maxeo/3dprint-skinkocchiali/documenti/anteprima.png

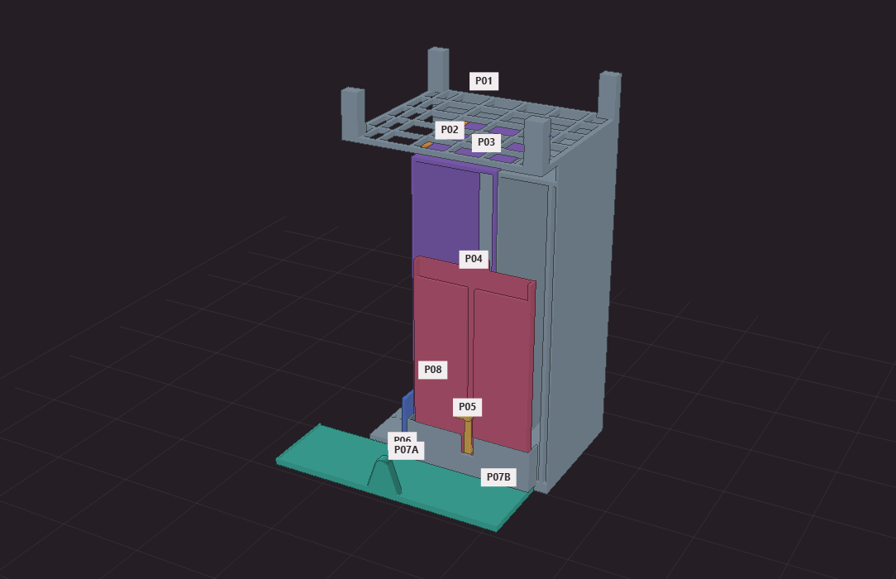
documenti/anteprima.png
