maxeo/3dprint-skinkocchiali/originale/01_modulo_principale.stl

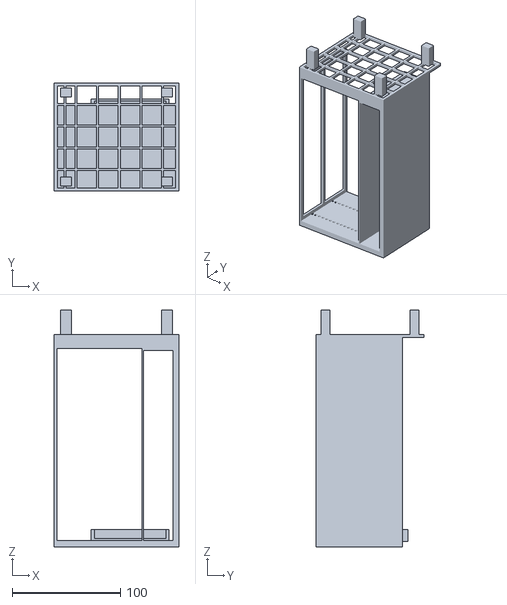
[picture p2: CAD file, 2026-09-13]
originale/01_modulo_principale.stl
115.0 x 100.0 x 218.7
