maxeo/3dprint-skinkocchiali/prove/T11_Tasca_porta_patch_con_base.stl

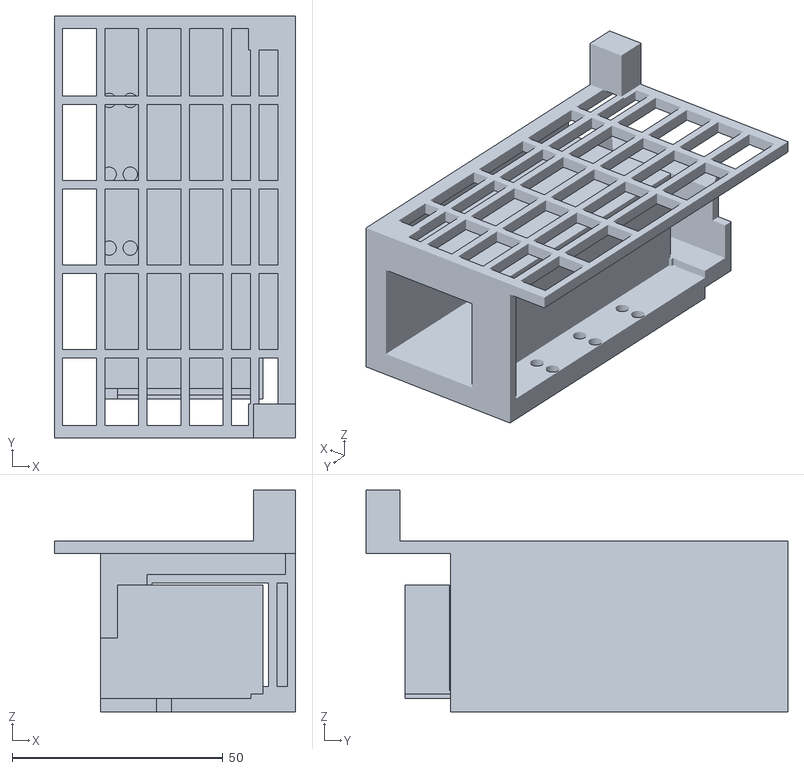
[picture p3: CAD file, 2026-10-20]
prove/T11_Tasca_porta_patch_con_base.stl
57.2 x 100.0 x 52.5
