maxeo/3dprint-skinkocchiali/stl/P01_Modulo_principale.stl

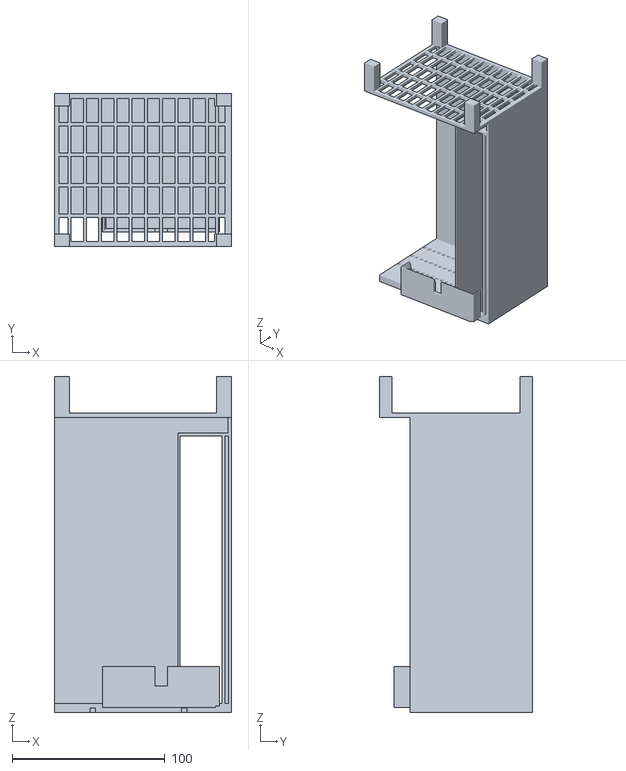
[picture p4: CAD file, 2026-10-20]
stl/P01_Modulo_principale.stl
116.2 x 100.0 x 220.3
