maxeo/3dprint-skinkocchiali/originale/04_porta_patch_traforato.stl

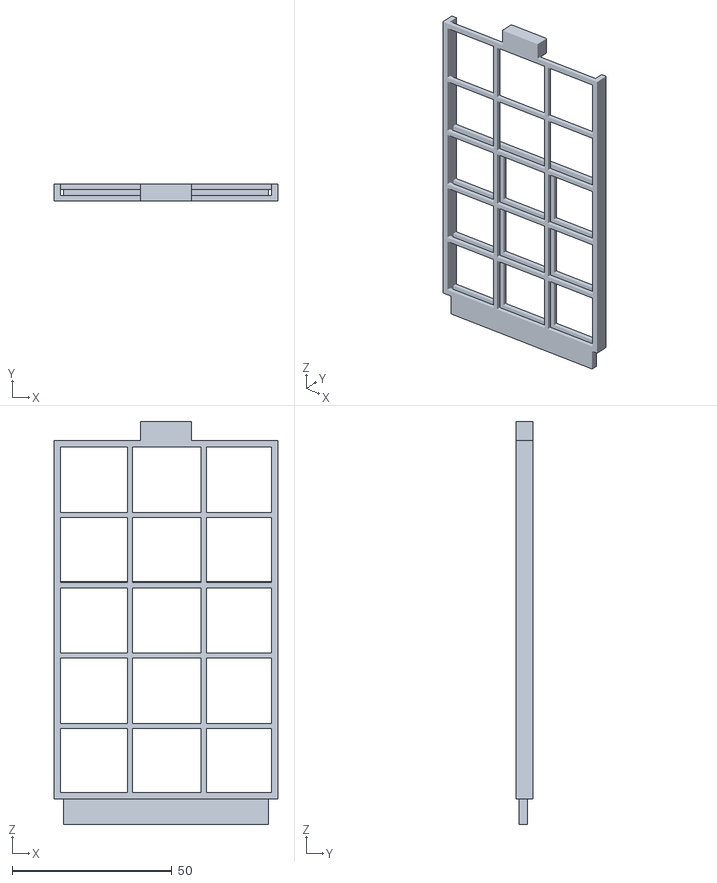
[picture p5: CAD file, 2026-09-13]
originale/04_porta_patch_traforato.stl
70.0 x 5.20 x 126.0
