maxeo/3dprint-skinkocchiali/prove/T03_Segmento_base_3_fori.stl

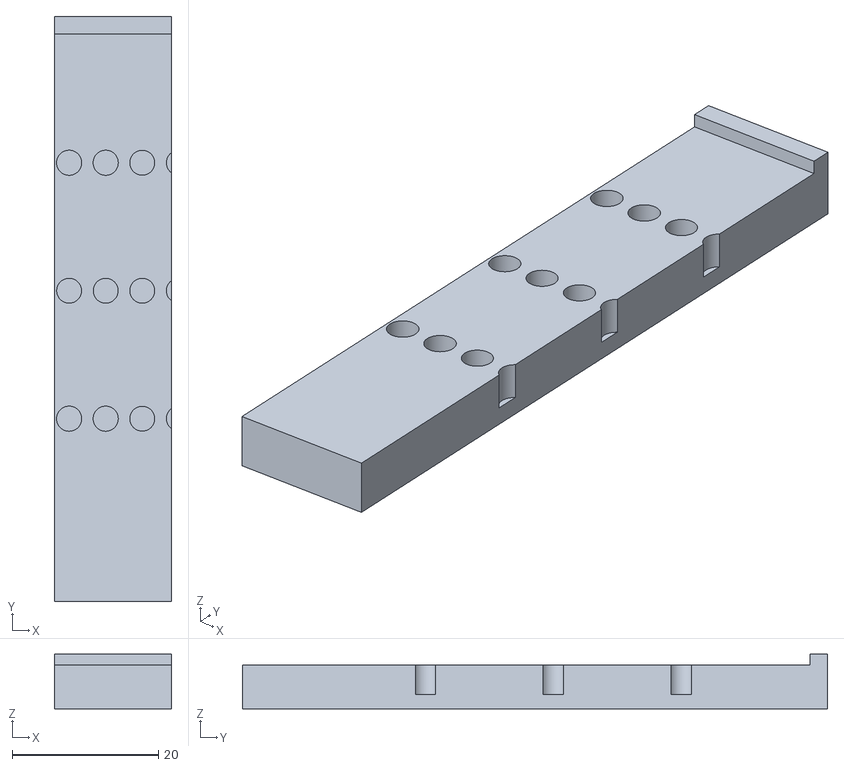
[picture p6: CAD file, 2026-10-20]
prove/T03_Segmento_base_3_fori.stl
16.0 x 80.0 x 7.50
