maxeo/3dprint-skinkocchiali/stl/P08_Fermo_L.stl

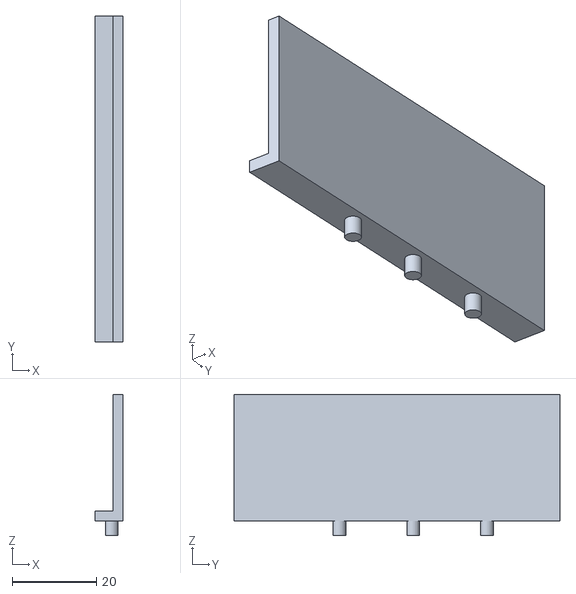
[picture p7: CAD file, 2026-09-26]
stl/P08_Fermo_L.stl
6.70 x 77.3 x 33.5
