maxeo/3dprint-skinkocchiali/originale/00_assieme_completo.stl

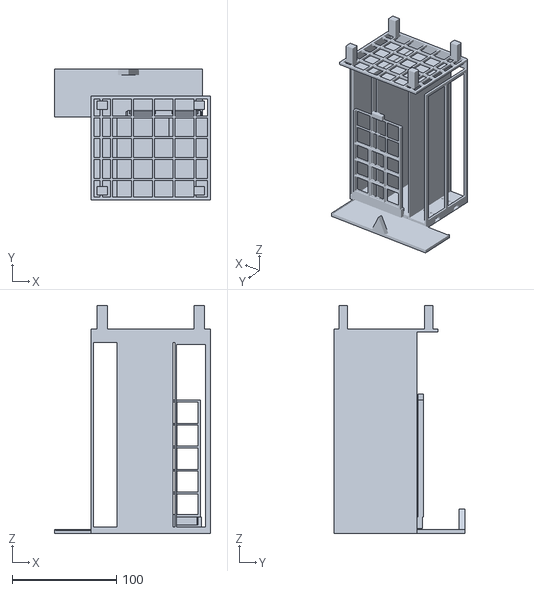
[picture p8: CAD file, 2026-09-13]
originale/00_assieme_completo.stl
150.0 x 126.1 x 218.7
