maxeo/3dprint-skinkocchiali/prove/T06_Chiave_S_spessore_1_7mm.stl

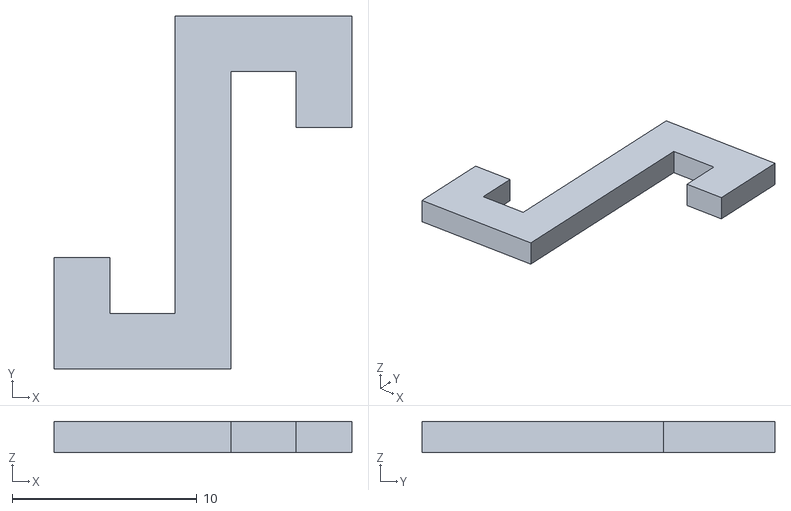
[picture p9: CAD file, 2026-10-20]
prove/T06_Chiave_S_spessore_1_7mm.stl
16.1 x 19.1 x 1.70
