maxeo/3dprint-skinkocchiali/stl/P07_Chiave_meandro.stl

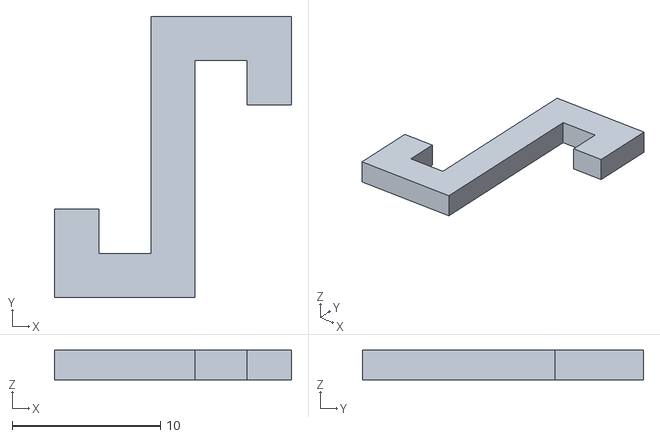
[picture p10: CAD file, 2026-09-26]
stl/P07_Chiave_meandro.stl
16.0 x 19.0 x 2.00
