maxeo/3dprint-skinkocchiali/originale/03_modulo_mobile_50x80.stl

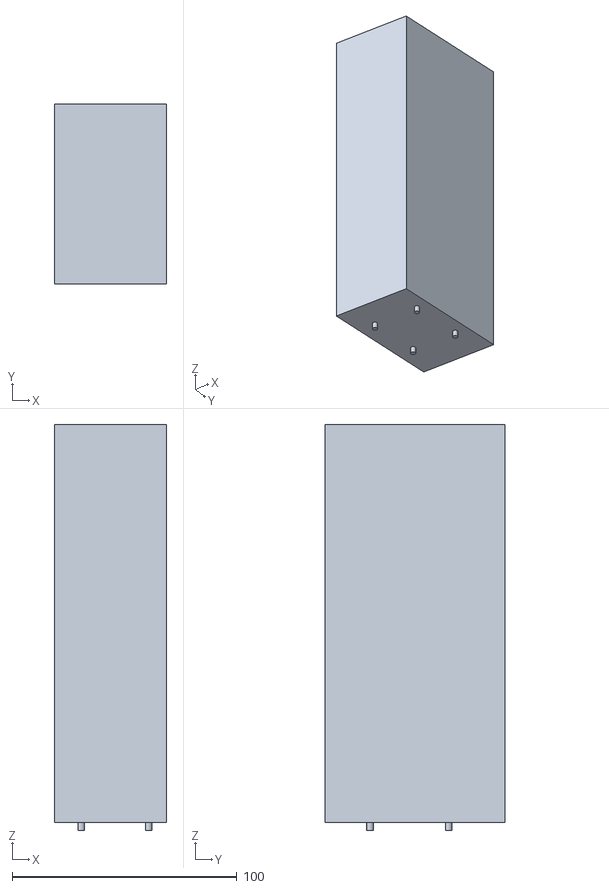
[picture p11: CAD file, 2026-09-13]
originale/03_modulo_mobile_50x80.stl
50.0 x 80.0 x 180.8
