maxeo/3dprint-skinkocchiali/prove/T08_Chiave_S_spessore_1_2mm.stl

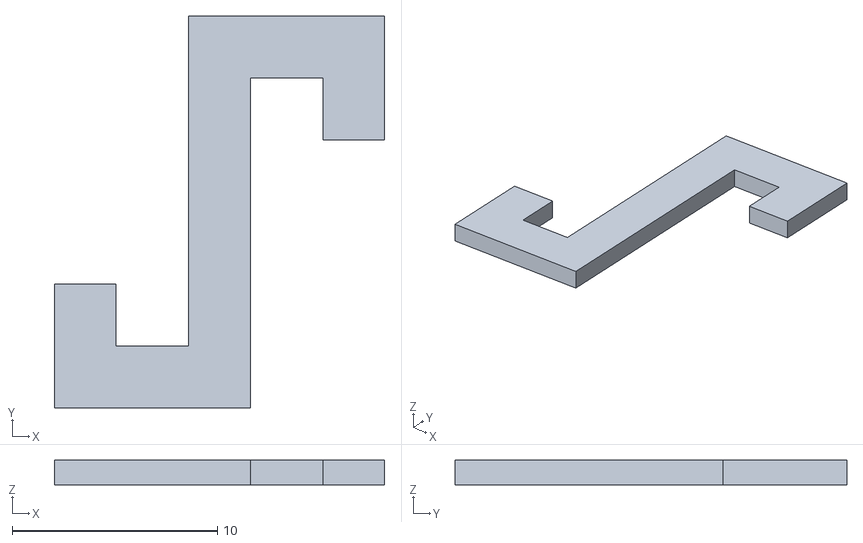
[picture p12: CAD file, 2026-10-20]
prove/T08_Chiave_S_spessore_1_2mm.stl
16.1 x 19.1 x 1.20
