maxeo/3dprint-skinkocchiali/stl/P06_Porta_occhiali.stl

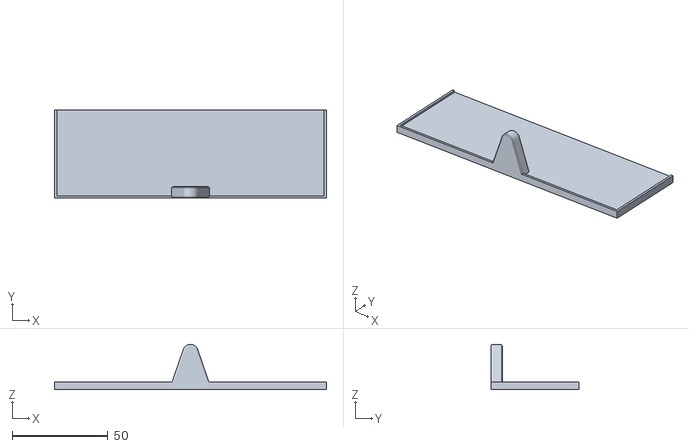
[picture p13: CAD file, 2026-09-26]
stl/P06_Porta_occhiali.stl
142.0 x 46.1 x 23.7
