maxeo/3dprint-skinkocchiali/originale/00_assieme_revisionato_NON_STAMPARE.stl

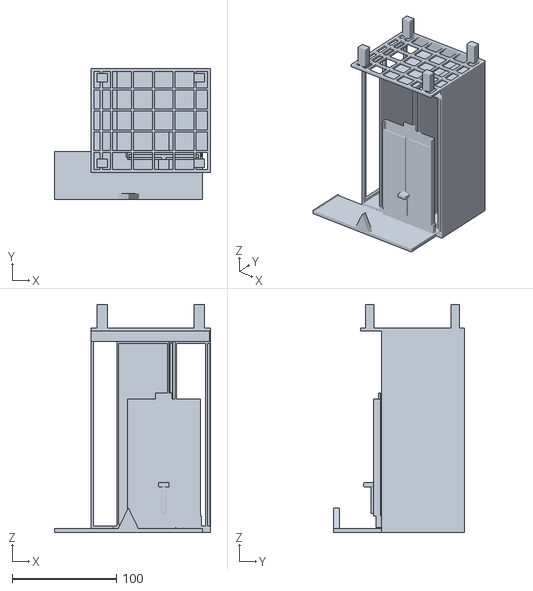
[picture p14: CAD file, 2026-09-13]
originale/00_assieme_revisionato_NON_STAMPARE.stl
150.0 x 126.1 x 218.7
