maxeo/3dprint-skinkocchiali/prove/T05_Provino_tasca_P06.stl

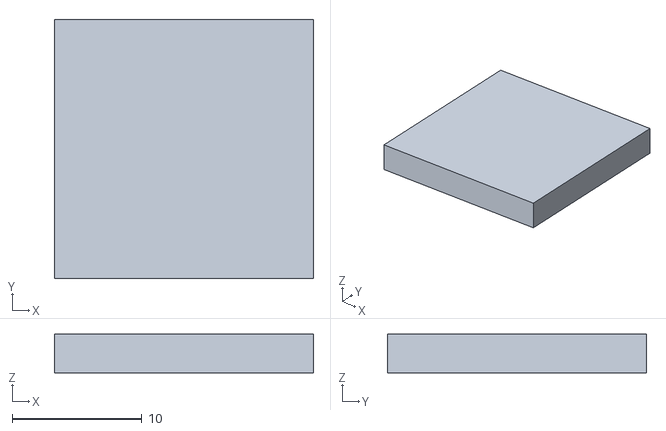
[picture p15: CAD file, 2026-10-20]
prove/T05_Provino_tasca_P06.stl
20.0 x 20.0 x 3.00
