maxeo/3dprint-skinkocchiali/stl/P02_Sezione_mobile_4x60.stl

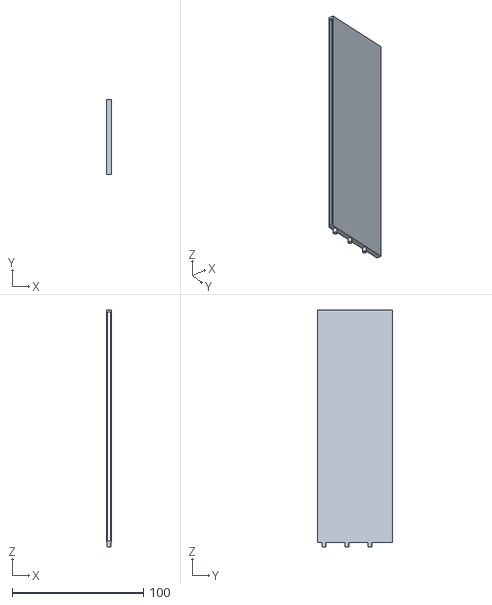
[picture p16: CAD file, 2026-09-13]
stl/P02_Sezione_mobile_4x60.stl
4.00 x 57.3 x 180.8
