maxeo/3dprint-skinkocchiali/originale/05_porta_occhiali_142x46_1.stl

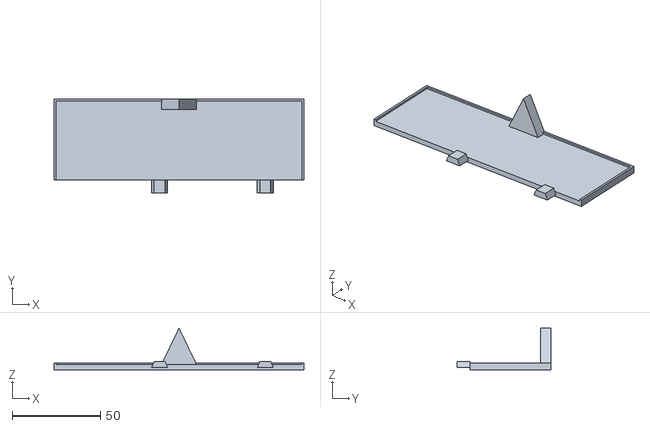
[picture p17: CAD file, 2026-09-13]
originale/05_porta_occhiali_142x46_1.stl
142.0 x 53.6 x 23.7
