maxeo/3dprint-skinkocchiali/prove/T04_Fetta_Sud_completa.stl

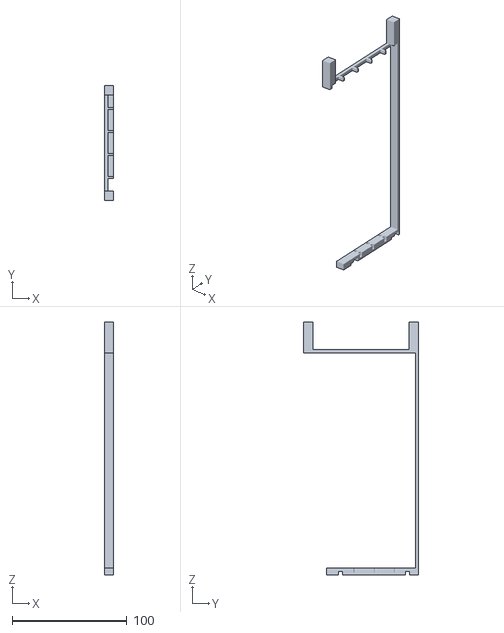
[picture p18: CAD file, 2026-10-20]
prove/T04_Fetta_Sud_completa.stl
8.00 x 100.0 x 220.3
