maxeo/3dprint-skinkocchiali/stl/P03_Sezione_mobile_50x80.stl

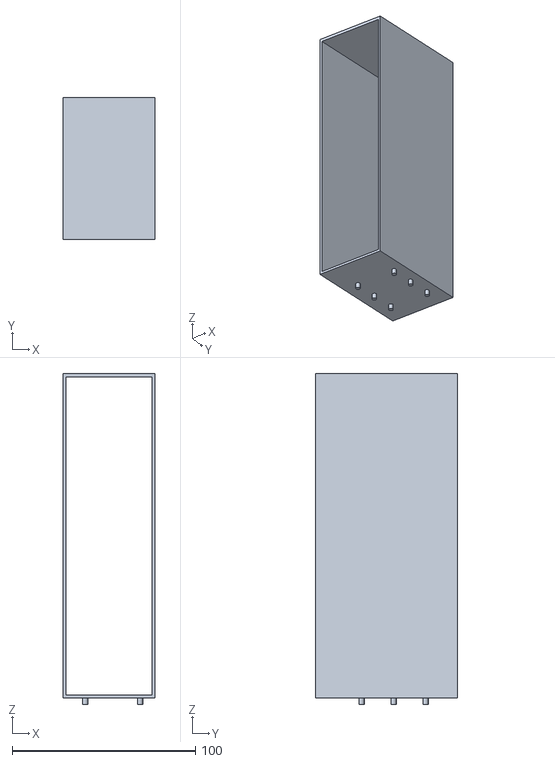
[picture p19: CAD file, 2026-09-13]
stl/P03_Sezione_mobile_50x80.stl
50.0 x 77.3 x 180.8
