maxeo/3dprint-skinkocchiali/originale/02_modulo_mobile_4x60.stl

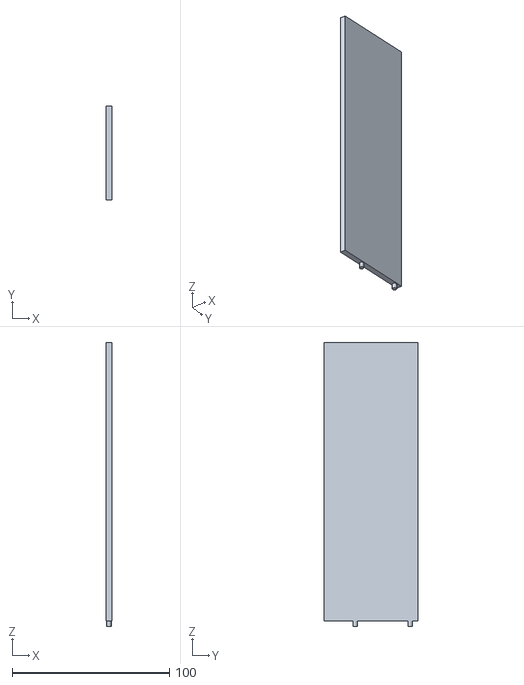
[picture p20: CAD file, 2026-09-13]
originale/02_modulo_mobile_4x60.stl
4.00 x 60.0 x 180.8
