maxeo/3dprint-skinkocchiali/prove/T11_Chiave_S_aderente_1_6mm.stl

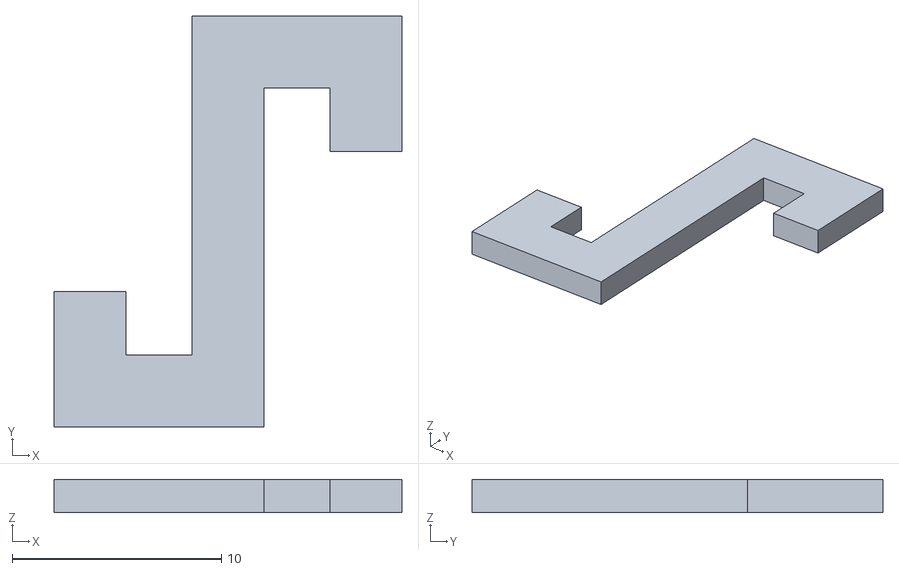
[picture p21: CAD file, 2026-10-20]
prove/T11_Chiave_S_aderente_1_6mm.stl
16.7 x 19.7 x 1.60
