maxeo/3dprint-skinkocchiali/stl/P05_Vassoio_con_asticella.stl

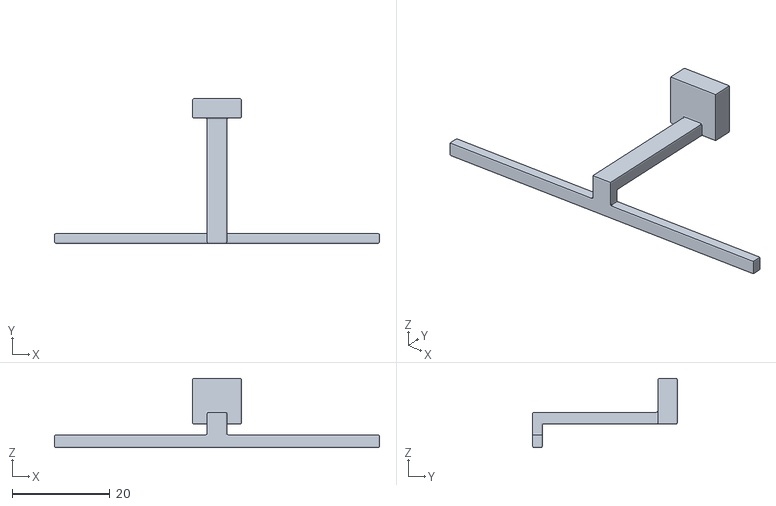
[picture p22: CAD file, 2026-09-13]
stl/P05_Vassoio_con_asticella.stl
66.4 x 29.6 x 14.1
