maxeo/3dprint-skinkocchiali/prove/T12_Test_bridge_2_25mm.stl

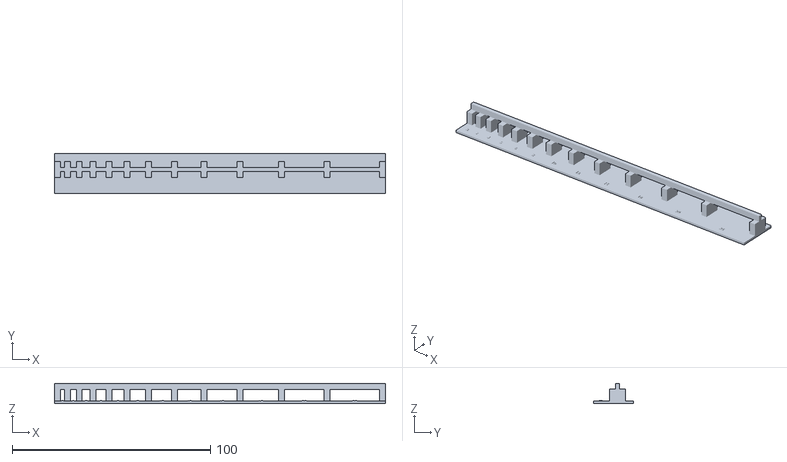
[picture p23: CAD file, 2026-10-20]
prove/T12_Test_bridge_2_25mm.stl
167.0 x 20.0 x 10.2
