maxeo/3dprint-skinkocchiali/stl/P04_Porta_patch_pieno.stl

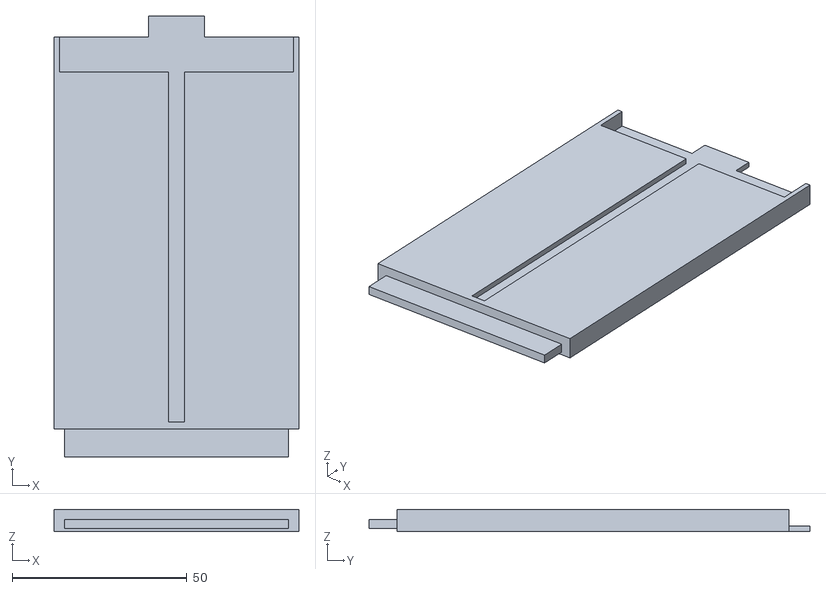
[picture p24: CAD file, 2026-09-13]
stl/P04_Porta_patch_pieno.stl
70.0 x 126.0 x 6.40
