maxeo/3dprint-skinkocchiali/prove/T09_Chiave_S_16_25x19_25x1_6mm.stl

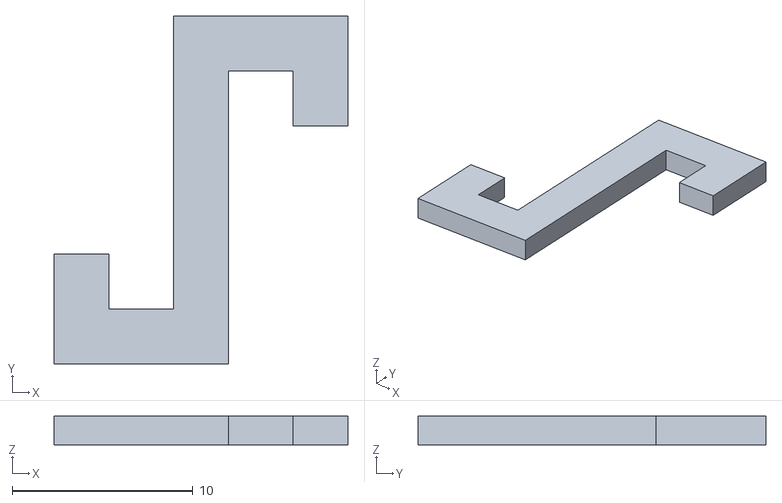
[picture p25: CAD file, 2026-10-20]
prove/T09_Chiave_S_16_25x19_25x1_6mm.stl
16.2 x 19.2 x 1.60
