maxeo/3dprint-skinkocchiali/prove/T10_Chiave_S_aderente_1_6mm.stl

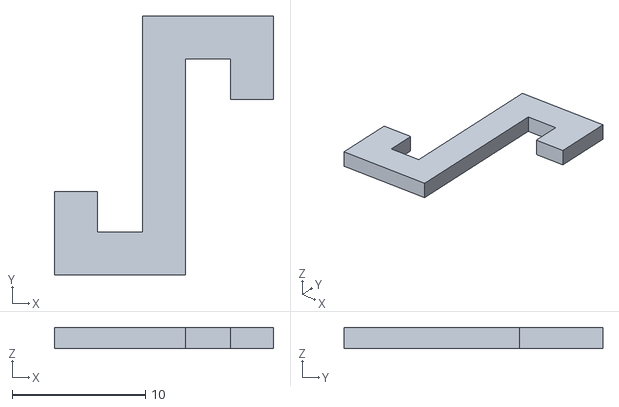
[picture p26: CAD file, 2026-10-20]
prove/T10_Chiave_S_aderente_1_6mm.stl
16.5 x 19.5 x 1.60
