maxeo/3dprint-skinkocchiali/prove/T07_Chiave_S_spessore_1_4mm.stl

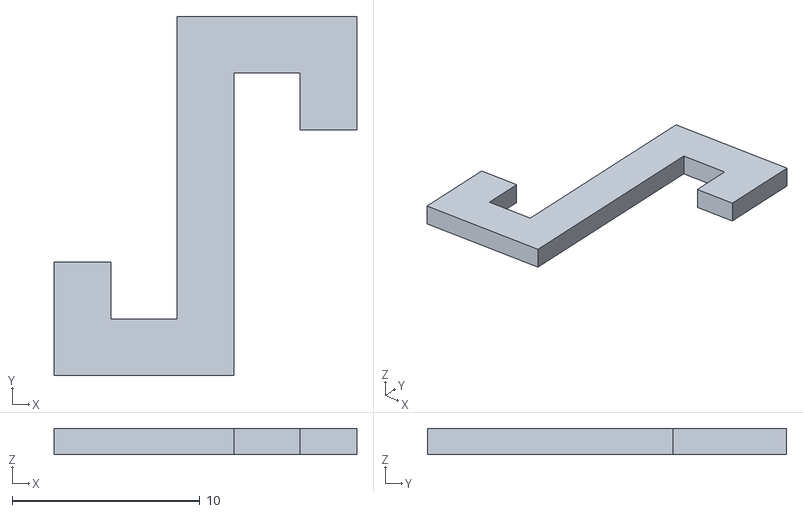
[picture p27: CAD file, 2026-10-20]
prove/T07_Chiave_S_spessore_1_4mm.stl
16.1 x 19.1 x 1.40
