maxeo/3dprint-skinkocchiali/prove/T12_Test_bridge_2_15mm.stl

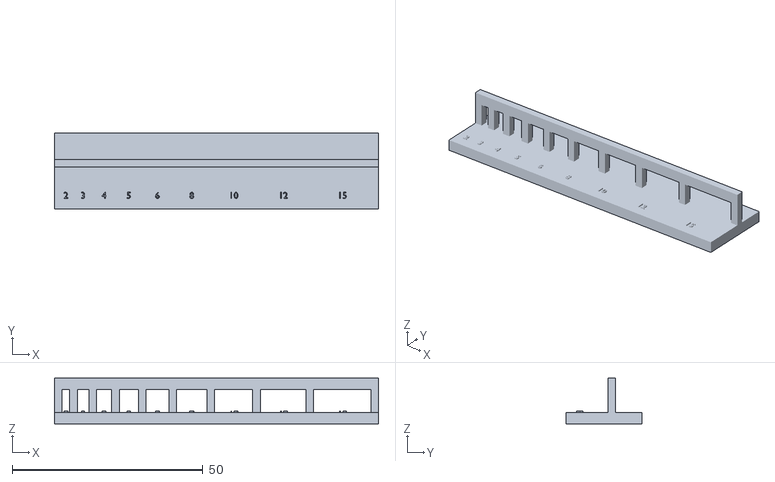
[picture p28: CAD file, 2026-10-20]
prove/T12_Test_bridge_2_15mm.stl
85.0 x 20.0 x 12.0
