maxeo/3dprint-skinkocchiali/prove/T01_Guida_porta_patch.stl

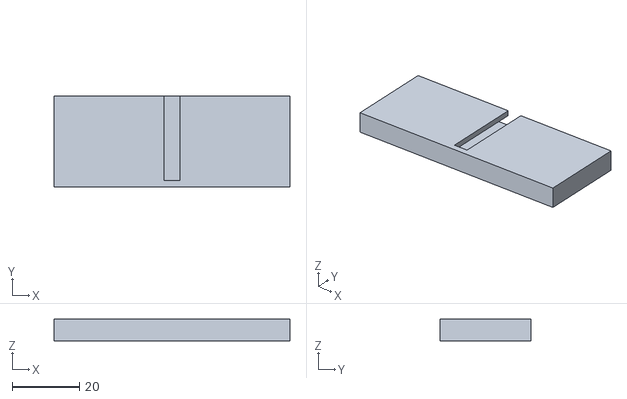
[picture p29: CAD file, 2026-09-13]
prove/T01_Guida_porta_patch.stl
70.0 x 27.0 x 6.40
