maxeo/3dprint-skinkocchiali/prove/T02_Cursore_porta_patch.stl

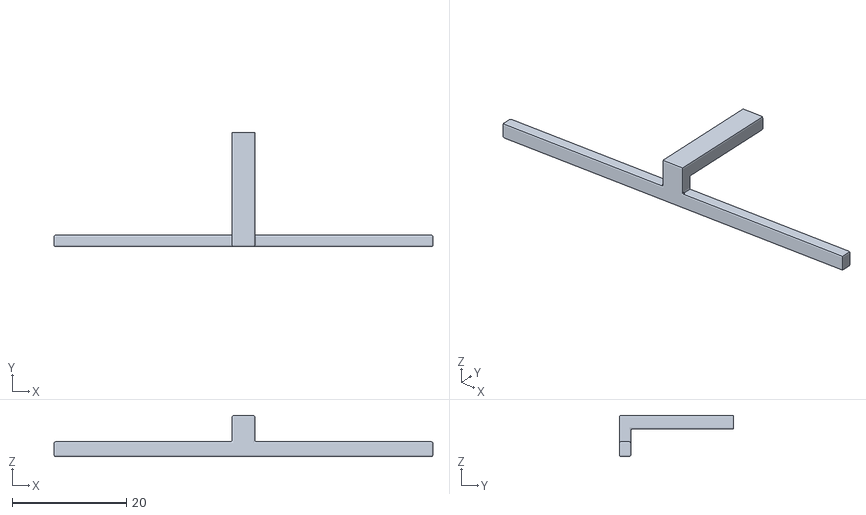
[picture p30: CAD file, 2026-09-13]
prove/T02_Cursore_porta_patch.stl
66.4 x 20.0 x 7.20
