maxeo/3dprint-skinkocchiali/(list of files, cad)

Other CAD files:
blender/SkinkOcchiali_v14.blend
