maxeo/3dprint-skinkocchiali/(commit log)

2026-09-13 Riorganizzato il progetto sulla revisione 14
    - Spostati i file della revisione 14 nella radice del progetto
    - Rimossa la brutta copia sistema_organizzazione_modulare_STL
    - Rimossi i documenti duplicati già presenti in originale/
    - Aggiornato il titolo del README
    [00_assieme_completo.stl, 00_assieme_revisionato_NON_STAMPARE.stl, 01_modulo_principale.stl, 02_modulo_mobile_4x60.stl, 03_modulo_mobile_50x80.stl, 04_porta_patch_traforato.stl, 05_porta_occhiali_142x46_1.stl, P01_Modulo_principale.stl]
2026-09-13 Aggiornati modulo, portaocchiali e guida di stampa
    - Rimosso il telaio Sud di P01 e aggiunta la parete posteriore
    - Spostati i fermi superiori agli angoli della grata
    - Aggiunta la terza fila di fori e invertiti P02 e P03
    - Sostituiti gli agganci di P06 con due chiavi a meandro (P07)
    - Aggiunto il fermo a L P08 e arrotondato il nasello di P06
    - Rigenerata la guida con la skill guida-stampa-3d
    - Aggiornati STL, verifiche, LEGGIMI, README e specifiche
    [P01_Modulo_principale.stl, P02_Sezione_mobile_4x60.stl, P03_Sezione_mobile_50x80.stl, P06_Porta_occhiali.stl, P07_Chiave_meandro.stl, P08_Fermo_L.stl, SkinkOcchiali_v14.blend]
2026-09-13 Rifatta la tasca del porta patch come un portapenne
    - Pareti della tasca alte 30 mm con 1 mm di gioco e bordo svasato
    - Aggiunto il varco per l'asticella di P05, verificato su 25 mm di corsa
    - Corrette le compenetrazioni nella vista 3D con lo z-buffer
    - Aggiornati STL di P01, guida, verifiche e documenti
    [P01_Modulo_principale.stl, SkinkOcchiali_v14.blend]
2026-09-26 Riorganizzati i file del progetto in cartelle
    - Spostati gli STL in stl, il blend in blender e i JSON in dati
    - Spostati testi, SVG e anteprima in documenti
    - Aggiunto root nello spec della guida, ora in dati
    - Aggiornati i percorsi in guida, README e JSON
    [P01_Modulo_principale.stl, P02_Sezione_mobile_4x60.stl, P03_Sezione_mobile_50x80.stl, P04_Porta_patch_pieno.stl, P05_Vassoio_con_asticella.stl, P06_Porta_occhiali.stl, P07_Chiave_meandro.stl, P08_Fermo_L.stl]
2026-09-26 Aggiunto il tema chiaro e scuro alla guida
    - Pulsante Sistema, Chiaro, Scuro con scelta condivisa tra le guide
2026-09-26 Nascoste le chiavi sotto P06 e aggiunto il perno a P08
    - Fessure a S di P06 trasformate in tasche aperte solo sotto
    - Ridotto lo spessore della chiave P07 da 2,8 a 2 mm
    - Aggiunto il terzo perno di P08 nella fila centrale dei fori
    - Aggiornato l'ordine di montaggio: chiavi sul piano, poi P06
    - Rigenerata la guida e aggiornati STL, Blender e documenti
    [P06_Porta_occhiali.stl, P07_Chiave_meandro.stl, P08_Fermo_L.stl, SkinkOcchiali_v14.blend]
2026-09-27 Aggiunto il pulsante Stampante alla guida
    - Area di stampa condivisa fra le guide e avviso sui pezzi che non entrano
2026-09-27 Aggiornato il controllo della stampante nella guida
    - Letti anche i pezzi con dimensions_mm
2026-09-27 Aggiunta la ricerca delle stampanti nella guida
    - Elenco di ~390 stampanti dai profili OrcaSlicer, con parole evidenziate
    - Pulsanti in cima alla pagina su mobile e margine sotto l'avviso
2026-09-27 Aggiunto sfondo chiaro agli schemi nel tema scuro
    - Schemi delle note leggibili anche con il tema scuro
2026-09-27 Resa leggibile la riga selezionata nel tema scuro
    - Riga selezionata della lista di stampa con sfondo scuro
2026-10-20 Aggiornati grata e porta patch di P01 e aggiunti i provini
    - Grata con colonne tutte strette (4,5–8 mm) per ponti corti in stampa
    - Fondo della tasca del porta patch abbassato a Z 3,2 mm sopra P06
    - Altezza del modulo portata a 220,3 mm con i fermi superiori allungati
    - Aggiunti i provini T03–T12 (tasche, chiavi a S, test bridge) e le relative verifiche
    - Rigenerati STL di P01, file blend, guida e documenti
    [P01_Modulo_principale.stl, SkinkOcchiali_v14.blend, T03_Segmento_base_3_fori.stl, T04_Fetta_Sud_completa.stl, T05_Provino_tasca_P06.stl, T06_Chiave_S_spessore_1_7mm.stl, T07_Chiave_S_spessore_1_4mm.stl, T08_Chiave_S_spessore_1_2mm.stl]
2026-10-20 Aggiornato il provino T11 e aggiunto il link alla guida
    - T11 con grata a colonne strette e tasca del porta patch abbassata
    - Nota su T03 e T04, che non includono le parti modificate
    - Link alla guida online nel README
    [T11_Tasca_porta_patch_con_base.stl]
2026-10-20 Ispessita la parete esterna Nord di P01 a 2 mm
    - Parete esterna Nord da 0,8 a 2 mm, modulo largo 116,2 mm
    - Fermi superiori Nord spostati di 1,2 mm senza cambiarne la misura
    - Stessa modifica sul provino T11; guida e documenti aggiornati
    [P01_Modulo_principale.stl, SkinkOcchiali_v14.blend, T11_Tasca_porta_patch_con_base.stl]
